thieu-b55/The---I-want-this---ESP32-S3-Internet-radio/README.md

# The---I-want-this---ESP32-S3-Internet-radio

WiFi or Ethernet connection, can be selected at start-up

+++++

With Ethernet connection, local ESP32 network to operate internet radio

Network:    ESP32webradio

Password:   ESP32pswd

address:    192.168.4.1

+++++

75 preset radio stations possible

About 50 completed

+++++

4” TFT Touch screen

burn-in protection

+++++

Local time

local time zone can be looked up via web page:

https://github.com/nayarsystems/posix_tz_db/blob/master/zones.csv

Specification Time Zone with TZ:

https://www.gnu.org/software/libc/manual/html_node/TZ-Variable.html

+++++

mp3 player

plays mp3 files randomly.

More than 5000+ files

+++++

Advanced EC11 - rotary encoder – signal processing.

Only 1 ESP32 GPIO input per EC11

absolutely interference-free

+++++

Control via

web page -> smartphone / desktop PC / laptop  conveniently in the office or workplace

2 rotary encoders

touch screen

+++++

Once programmed, all settings can be adjusted via web page:

Network ssid

Network password

local time zone

ntp server

freely selectable IP address (within range of your own router)

+++++

Excellent sound quality thanks to:

https://github.com/schreibfaul1/ESP32-audioI2S

+++++

With volume and equalizer(webpage) control

+++++

Easy to build

+++++

To avoid problems with incompatible library updates

used libraries available on Github page

+++++

Internet_ETH_WiFi.bin file present on Github page can easily be programmed in the ESP32 with <esptool.py>

ALWAYS a working software version

https://docs.espressif.com/projects/esptool/en/latest/esp32/installation.html#installation
