thieu-b55/The---I-want-this---ESP32-S3-Internet-radio/(threads)

Thread 1 (2024-12-28):

Pin Anschluss Arduino

adrianoaebli, 2024-12-28:
Hi Thieu-b55
Sollte es in der Zeile "C11 with ATTINY85 output on IC pin 2 (Arduino Pin 3)" im Pdf nicht heissen: "(Arduino Pin **13**)" ?

thieu-b55, 2024-12-30:
Not according to the attached illustration that I found on the internet

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

adrianoaebli, 2025-01-11:
Hallo thieu-b55 bei mir hat es mit pin 13 funktioniert, liegt aber wahrscheilich daran, wie man den Arduino als Programmer verwendet. Ich habe es mit folgender Anleitung gemacht: #https://wolles-elektronikkiste.de/attiny-mit-arduino-code-programmieren#attinycore_vs_attiny.
Mein Webradio ist nun fertig aufgebaut und funktioniert wie es sollte. Ich habe allerdings zwei Anliegen:
1. Ich möchte den Bildschirm um 180 Grad drehen. Für den Text ist es ja möglich, in der Datei Internetradio_ETH_WIFI.ino in Zeile 1650 den Wert von "tft.setRotation(3)" auf 1 zu stellen. Ich finde aber nicht raus, wie ich die TOUCH-Funktion des Bildschirms ebenfalls drehen kann.
2. Ich möchte die Mp3 nicht zufällig spielen, sondern in der Reihenfolge, wie sie in den Ordnern ist, wie kann ich das programmieren?
Herzlichen Dank!

thieu-b55, 2025-02-10:
hi Adriano,

Sorry for the late answer.

Not really an idea how to rotate the touch function by 180 degrees. Maybe contact the author of the TFT-eSPI library

I have not tried it, but you can try this to play the MP3 files one after the other

line 155
int volgend = 0;

line 522
volgend = random(totalmp3);

replaced by
volgend ++;

make sure that volgend does not exceed the number of mp3 files.

good luck,
thieu

thieu-b55, 2025-02-10:
hi Adriano,

about touch()

line 1650 set the desired rotation

line 117
#define REPEAT_CAL                      false
replace with
#define REPEAT_CAL                      true
reprogram the radio
restart the radio
calibrate the touch
shutdown radio  and reprogram with
 the old value
#define REPEAT_CAL                      false

I'm not sure but I think this is going to work

greetings,
thieu

Closed 2024-12-31.
